frenchbakery/batmon/hardware/esp32version/BatMon.kicad_pcb

## KiCad design hardware/esp32version/BatMon.kicad_pcb (2023-06-28)

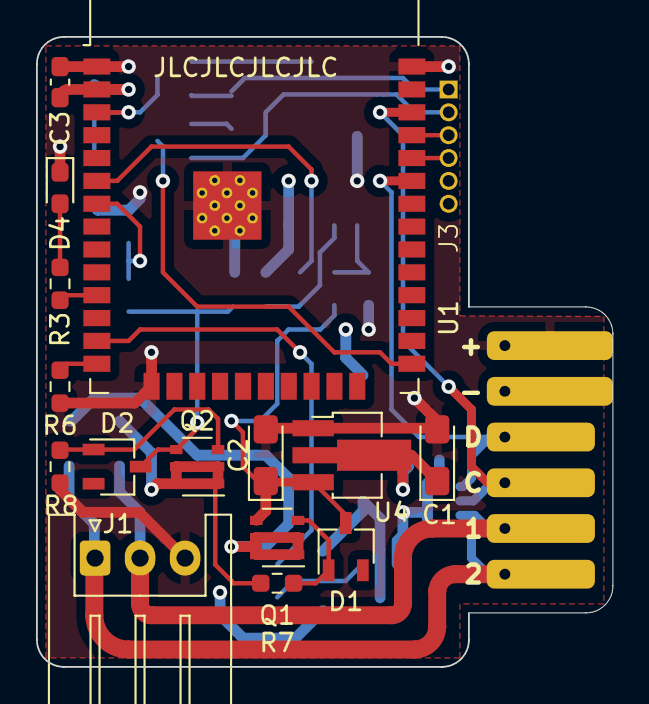
[picture p1: board BatMon.kicad_pcb from above]

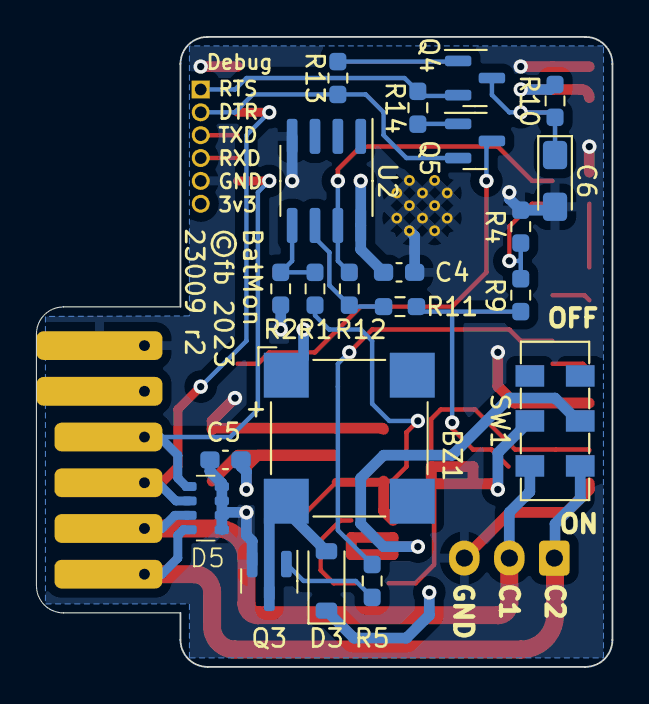
[picture p2: board BatMon.kicad_pcb from below]

Board: 4 copper layers, 32.0 x 35.0 mm, 38 parts (21 on the bottom side), 30 nets.

Parts:
BZ1: Buzzer; MagneticBuzzer_CUI_CMT-8504-100-SMT
C1, C2, C6: 22µ; CP_EIA-3216-18_Kemet-A_Pad1.58x1.35mm_HandSolder
C3, C4, C5: 100n; C_0603_1608Metric_Pad1.08x0.95mm_HandSolder
D1, D2: D_Zener_ANK; TSOT-23
D3: D_Schottky; D_SOD-123
D4: LED; LED_0603_1608Metric_Pad1.05x0.95mm_HandSolder
D5: D_TVS_Quad_Array_1206
J1: Battery_Connector; JST_XH_S3B-XH-A_1x03_P2.50mm_Horizontal
J3: Prog_Connector; Dbg_Port_1x6_P1.27mm_ThroughHole
J5: Charging_Connector; Conn_Edge_1x6_LLSSSS_Mirrored
Q1, Q2: Q_PMOS_DDGSDD_TSOP-6; TSOP-6_1.65x3.05mm_P0.95mm
Q3, Q4, Q5: SS8050-G; SOT-23
R1, R11: 30k; R_0603_1608Metric_Pad0.98x0.95mm_HandSolder
R2, R4, R6, R10, R12, R13, R14: 10k; R_0603_1608Metric_Pad0.98x0.95mm_HandSolder
R3, R5, R7, R8: 330; R_0603_1608Metric_Pad0.98x0.95mm_HandSolder
R9: 20k; R_0603_1608Metric_Pad0.98x0.95mm_HandSolder
SW1: POWER_SW; SW_DPDT_Nidec_CL-SB-22A-1x
U1: ESP32-WROOM-32D
U2: LM2904; SOIC-8_3.9x4.9mm_P1.27mm
U4: AZ1117CR-3.3; SOT-89-3_Handsoldering

Connections:
+3.3V: BZ1.1 (-), C1.1, C3.1, C4.1, C5.1, D3.1 (K), J3.6, J5.2, R10.2, U1.2 (VDD), U2.8 (V+), U4.2 (VO)
/C1RAW: D5.3 (A1), J1.2, J5.5, SW1.1 (A)
/C2RAW: D5.4 (A1), J1.1, J5.6, SW1.4 (A)
/RXD: J3.4, U1.34 (RXD0/IO3)
/TXD: J3.3, U1.35 (TXD0/IO1)
Buzzer: R5.2, U1.13 (IO14)
C1ADC: R4.1, R9.2, U1.7 (IO35)
C1IN: D2.3 (K), Q2.4 (S), R9.1, R11.2
C2ADC: R12.1, U1.6 (IO34), U2.7
C2IN: C2.1, D1.3 (K), Q1.4 (S), R1.2, U4.3 (VI)
ESP_EN: C6.1, Q4.3 (C), R10.1, U1.3 (EN)
ESP_IO0: Q5.3 (C), U1.25 (IO0)
GND: C1.2, C2.2, C3.2, C4.2, C5.2, C6.2, D4.1 (K), D5.5 (A2), D5.6 (A2), D5.7 (A2), D5.8 (A2), J1.3, J3.5, J5.1, Q3.2 (E), R2.2, R4.2, R6.2, R8.1, U1.1 (GND), U1.15 (GND), U1.38 (GND), U1.39 (GND), U2.4 (V-), U4.1 (GND)
unnamed: BZ1.2 (+), D3.2 (A), Q3.3 (C)
unnamed: D4.2 (A), R3.1
unnamed: D1.1 (A), Q1.3 (G), R7.2
unnamed: D2.1 (A), Q2.3 (G), R8.2
unnamed: Q3.1 (B), R5.1
unnamed: Q4.1 (B), R13.1
unnamed: Q5.1 (B), R14.1
unnamed: Q2.1 (D), Q2.2 (D), Q2.5 (D), Q2.6 (D), R7.1, SW1.2 (B)
unnamed: Q1.1 (D), Q1.2 (D), Q1.5 (D), Q1.6 (D), SW1.5 (B)
unnamed: R6.1, U1.14 (IO12)
unnamed: R3.2, U1.11 (IO26)
unnamed: R1.1, R2.1, U2.5 (+)
unnamed: R11.1, R12.2, U2.6 (-)
PROG_DTR: J3.2, Q5.2 (E), R13.2
PROG_RTS: J3.1, Q4.2 (E), R14.2
SCL: D5.2 (A1), J5.4, U1.36 (IO22)
SDA: D5.1 (A1), J5.3, U1.33 (IO21)
