frenchbakery/batmon/hardware/batmon_simple_pcb/batmon_simple_pcb.kicad_pcb

## KiCad design hardware/batmon_simple_pcb/batmon_simple_pcb.kicad_pcb (2023-04-15)

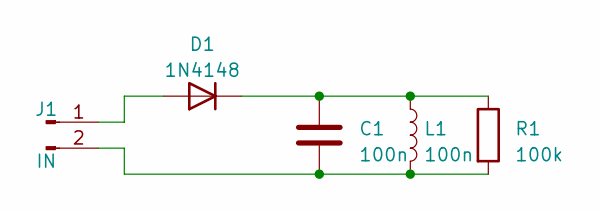
[picture p3: schematic batmon_simple_pcb.kicad_sch]

Parts:
C1: 100n; C_0603_1608Metric_Pad1.08x0.95mm_HandSolder
D1: 1N4148; D_MicroMELF
J1: IN; PinHeader_1x02_P2.54mm_Horizontal
L1: 100n; L_Bourns-SRN4018
R1: 100k; R_0603_1608Metric_Pad0.98x0.95mm_HandSolder

Connections:
unnamed: D1.2 (A), J1.1
unnamed: C1.1, D1.1 (K), L1.1, R1.1
unnamed: C1.2, J1.2, L1.2, R1.2

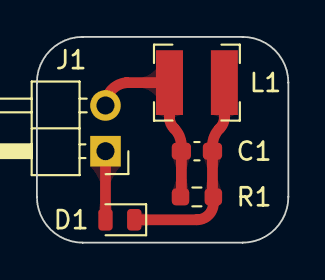
[picture p4: board batmon_simple_pcb.kicad_pcb from above]

Board: 2 copper layers, 14.0 x 11.4 mm, 5 parts (0 on the bottom side), 3 nets.
