frenchbakery/batmon/firmware/include/pitches.h

#define HZ_NOTE_B0  31
#define HZ_NOTE_C1  33
#define HZ_NOTE_CS1 35
#define HZ_NOTE_D1  37
#define HZ_NOTE_DS1 39
#define HZ_NOTE_E1  41
#define HZ_NOTE_F1  44
#define HZ_NOTE_FS1 46
#define HZ_NOTE_G1  49
#define HZ_NOTE_GS1 52
#define HZ_NOTE_A1  55
#define HZ_NOTE_AS1 58
#define HZ_NOTE_B1  62
#define HZ_NOTE_C2  65
#define HZ_NOTE_CS2 69
#define HZ_NOTE_D2  73
#define HZ_NOTE_DS2 78
#define HZ_NOTE_E2  82
#define HZ_NOTE_F2  87
#define HZ_NOTE_FS2 93
#define HZ_NOTE_G2  98
#define HZ_NOTE_GS2 104
#define HZ_NOTE_A2  110
#define HZ_NOTE_AS2 117
#define HZ_NOTE_B2  123
#define HZ_NOTE_C3  131
#define HZ_NOTE_CS3 139
#define HZ_NOTE_D3  147
#define HZ_NOTE_DS3 156
#define HZ_NOTE_E3  165
#define HZ_NOTE_F3  175
#define HZ_NOTE_FS3 185
#define HZ_NOTE_G3  196
#define HZ_NOTE_GS3 208
#define HZ_NOTE_A3  220
#define HZ_NOTE_AS3 233
#define HZ_NOTE_B3  247
#define HZ_NOTE_C4  262
#define HZ_NOTE_CS4 277
#define HZ_NOTE_D4  294
#define HZ_NOTE_DS4 311
#define HZ_NOTE_E4  330
#define HZ_NOTE_F4  349
#define HZ_NOTE_FS4 370
#define HZ_NOTE_G4  392
#define HZ_NOTE_GS4 415
#define HZ_NOTE_A4  440
#define HZ_NOTE_AS4 466
#define HZ_NOTE_B4  494
#define HZ_NOTE_C5  523
#define HZ_NOTE_CS5 554
#define HZ_NOTE_D5  587
#define HZ_NOTE_DS5 622
#define HZ_NOTE_E5  659
#define HZ_NOTE_F5  698
#define HZ_NOTE_FS5 740
#define HZ_NOTE_G5  784
#define HZ_NOTE_GS5 831
#define HZ_NOTE_A5  880
#define HZ_NOTE_AS5 932
#define HZ_NOTE_B5  988
#define HZ_NOTE_C6  1047
#define HZ_NOTE_CS6 1109
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
#define NR_NOTE_E7  100
#define NR_NOTE_F7  101
#define NR_NOTE_FS7 102
#define NR_NOTE_G7  103
#define NR_NOTE_GS7 104
#define NR_NOTE_A7  105
#define NR_NOTE_AS7 106
#define NR_NOTE_B7  107
#define NR_NOTE_C8  108
#define NR_NOTE_CS8 109
#define NR_NOTE_D8  110
#define NR_NOTE_DS8 111
