frenchbakery/batmon/test_firmware/include/pins.h

/**
 * @file pins.h
 * @author melektron
 * @brief pinout
 * @version 0.1
 * @date 2023-07-03
 * 
 * @copyright Copyright FrenchBakery (c) 2023
 * 
 */

#pragma once

#define BUZZER 14
#define LED 26
#define WRONG_C1I 16
#define WRONG_C2I 17
#define C1I 35
#define C2I 34
