frenchbakery/batmon/(commit log)

2023-04-15 added test circuit for kicad 7
    [batmon_simple_pcb.kicad_pcb, batmon_simple_pcb.kicad_sch]
2023-04-27 test version
    [A320_SW_0001_Square_Button_kicad.step, BatMon.dxf, BatMon.kicad_pcb, BatMon.kicad_sch, Lorlin_CK-Series_rotary_switch.step, SUNLIGHT_13x10x7_7_segment_display.step, WS2812B-2020.step]
2023-05-30 started refactoring esp32 batmon
    [BatMon.kicad_sch]
2023-05-31 cleaned up schematic
    [BatMon.kicad_sch]
2023-06-01 added propper el_kicad_libs
    [A320_SW_0001_Square_Button_kicad.step, BatMon.kicad_sch, Lorlin_CK-Series_rotary_switch.step, SUNLIGHT_13x10x7_7_segment_display.step, WS2812B-2020.step]
2023-06-01 reverse polarity zeners now correct pinout
    [BatMon.kicad_sch]
2023-06-01 updated PCB
    [BatMon.kicad_pcb, BatMon.kicad_sch]
2023-06-01 no changes
    [BatMon.kicad_sch]
2023-06-01 implemented new analog section, started component selection process
    [BatMon.kicad_pcb, BatMon.kicad_sch]
2023-06-02 worked on schematic and part selection
    [BatMon.kicad_sch]
2023-06-02 started working on new layout
    [BatMon.kicad_pcb, BatMon.kicad_sch]
2023-06-02 first iteration of new pcb done
    [BatMon.kicad_pcb, BatMon.kicad_sch]
2023-06-02 minor changes, round corners
    [BatMon.kicad_pcb, BatMon.kicad_sch]
2023-06-03 added a switch and fixed the battery pinout
    [BatMon.kicad_pcb, BatMon.kicad_sch]
2023-06-03 finalized design and exported gerbers
    [BatMon-B_Cu.gbl, BatMon-B_Mask.gbs, BatMon-B_Paste.gbp, BatMon-B_Silkscreen.gbo, BatMon-Edge_Cuts.gm1, BatMon-F_Cu.gtl, BatMon-F_Mask.gts, BatMon-F_Paste.gtp]
2023-06-03 added part fields and bom
    [BatMon.kicad_pcb, BatMon.kicad_sch]
2023-06-05 increased minimal via sizing to reduce cost
    [BatMon-B_Cu.gbl, BatMon-B_Mask.gbs, BatMon-B_Paste.gbp, BatMon-B_Silkscreen.gbo, BatMon-Edge_Cuts.gm1, BatMon-F_Cu.gtl, BatMon-F_Mask.gts, BatMon-F_Paste.gtp]
2023-06-28 fixed battery inputs being connected to non ADC pins on uC (new board revision)
    [BatMon-B_Cu.gbl, BatMon-B_Mask.gbs, BatMon-B_Paste.gbp, BatMon-B_Silkscreen.gbo, BatMon-Edge_Cuts.gm1, BatMon-F_Cu.gtl, BatMon-F_Mask.gts, BatMon-F_Paste.gtp]
2023-07-03 got LED blinking to work with normal esp idf, scrapped c++ component
2023-07-04 implemented LED driver with task
2023-07-04 tested LED blinking and adjusted blink timing
2023-07-04 updated programming connector to correct mouser component
    [BatMon.kicad_sch]
2023-07-04 got ADC to work
2023-07-04 adc calibration working
2023-07-05 created a proper battery module
2023-07-05 used multi sampling of cell voltage
2023-07-05 implemented basic buzzer tones
    [battery.hpp, buzzer.cpp, buzzer.hpp, led.cpp, main.cpp]
2023-07-05 added buzzer startup sound
    [buzzer.cpp, buzzer.hpp, main.cpp, pitches.h]
2023-07-06 attempted to implement proper behaviour, but task deletion causes unpredictable crashes
    [buzzer.cpp, buzzer.hpp, led.cpp, led.hpp, main.cpp, settings.cpp]
2023-07-06 restructured buzzer and led drivers to work more cleanly and use task notifications instead of deleting tasks over and over again. Buzzer and LED are not working properly
    [buzzer.cpp, buzzer.hpp, led.cpp, led.hpp, main.cpp, utils.hpp]
