frenchbakery/batmon/(notices)

Notices in the files:
hardware/esp32version/BatMon.kicad_pcb:
©fb 2023
